PacketRadio80/T-Modem-c1224/hardware/README.md

# Hardware — T-Modem-c1224

| Path | Content | Git |
|---|---|-----|
| [`BOM.md`](BOM.md) | Planning BOM (public) | **tracked** |
| [`bom/BOM.csv`](bom/BOM.csv) | Machine-readable BOM | **tracked** |
| [`kicad/README.md`](kicad/README.md) | Pointer only | tracked stub |
| `../local/kicad/t-modem-c1224/` | Live schematic + PCB | **local only** until finished |
