PacketRadio80/T-Modem-c1224/firmware/README.md

# Firmware

Product image: **[`c1224/`](c1224/)** — one UF2 (Pico service FW).

See [`c1224/README.md`](c1224/README.md) for build, flash, pins, INI, CDC.
