PacketRadio80/T-Modem-c1224/hardware/kicad/README.md

# KiCad

Tracked project: **`hardware/kicad/t-modem-c1224/`** (fab-ready **v1.0-prototype**).

Working copies under `local/kicad/` remain gitignored for operator scratch; ship gold lives here.
