PacketRadio80/T-Modem-c1224/local/kicad/t-modem-c1224/README.md

# KiCad — T-Modem-c1224

| File | Role |
|---|---|
| `t-modem-c1224.kicad_sch` | Schematic (nets · USB VBUS isolated) |
| `t-modem-c1224.kicad_pcb` | **180×180 mm** · footprints + pads + nets · **no routed traces** |
| `t-modem-c1224.kicad_pro` | Project |

**Do not** Freeroute or hand-route until operator orders. Ratsnest only.
