PacketRadio80/T-Modem-c1224/docs/figures/c1224-board-overview.png

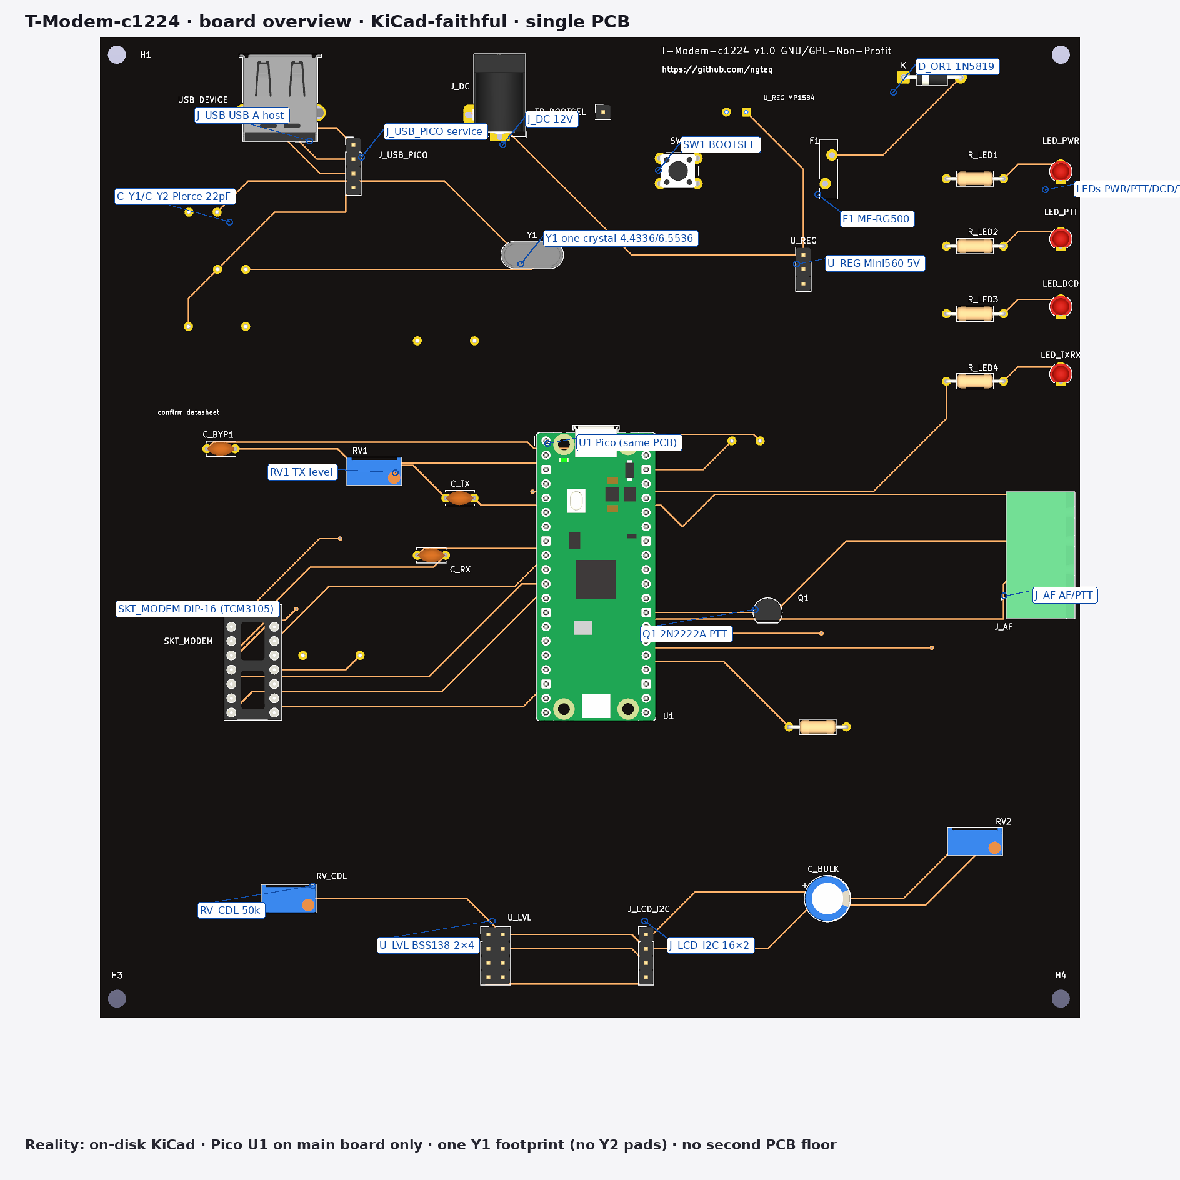
docs/figures/c1224-board-overview.png
