PacketRadio80/T-Modem-c1224/docs/figures/fig-01-pcb-standoffs.png

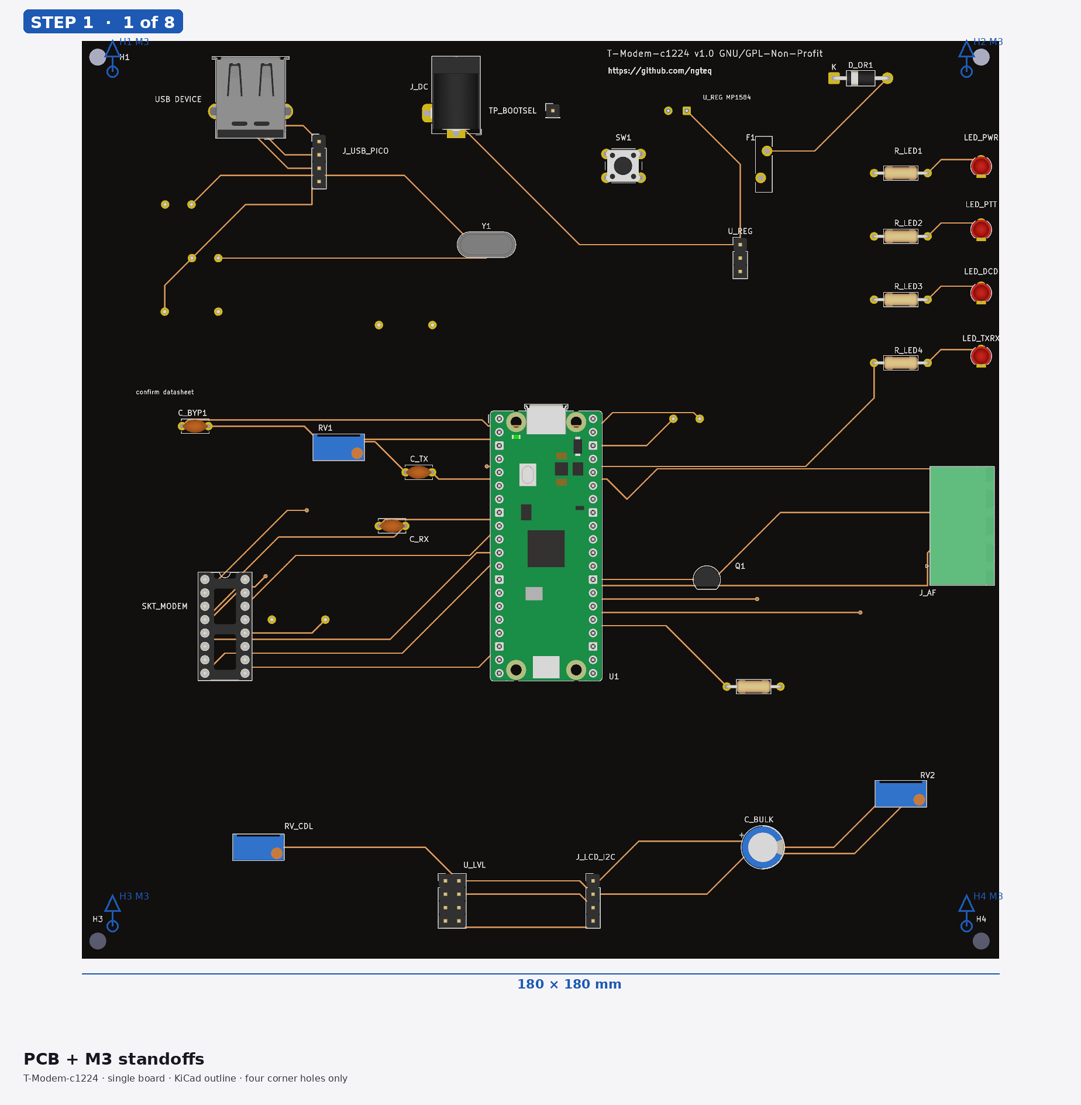
docs/figures/fig-01-pcb-standoffs.png
