PacketRadio80/T-Modem-c1224/docs/figures/fig-02-power-section.png

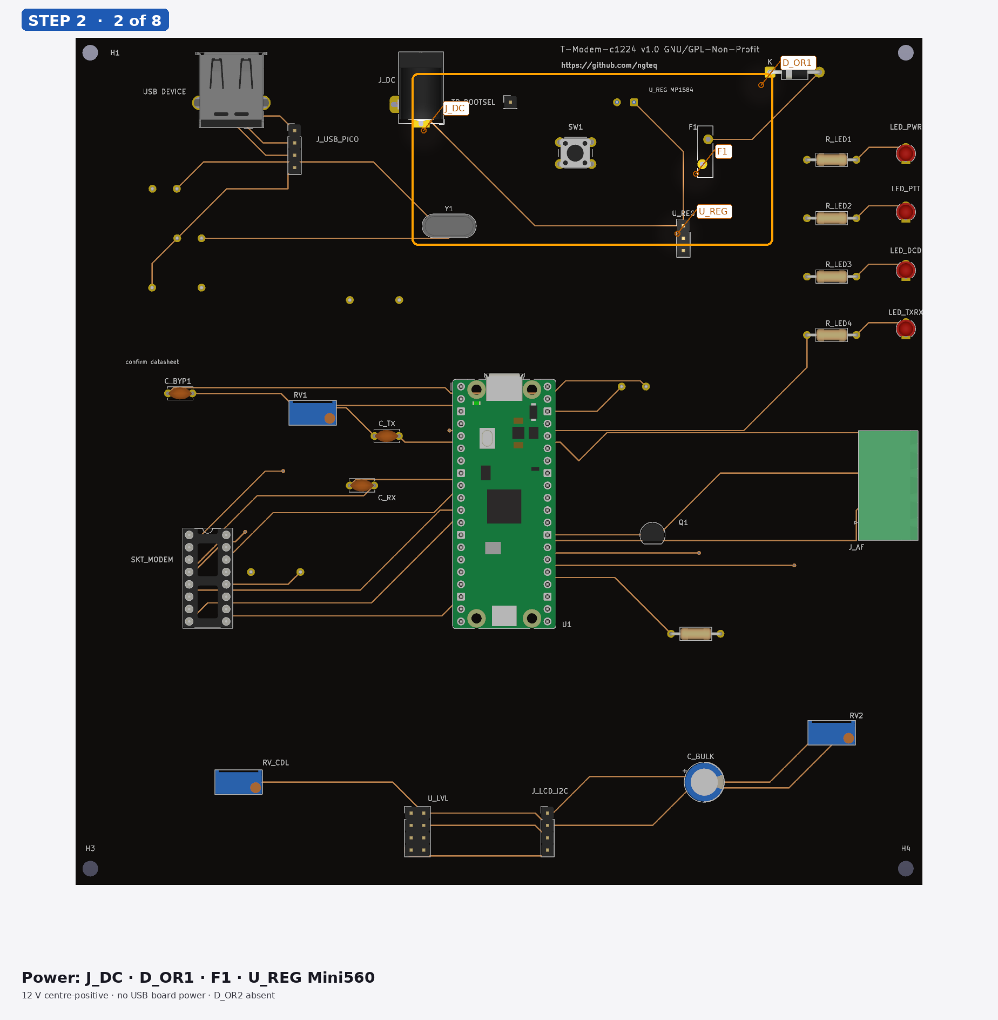
docs/figures/fig-02-power-section.png
