PacketRadio80/T-Modem-c1224/docs/figures/fig-03-modem-crystal.png

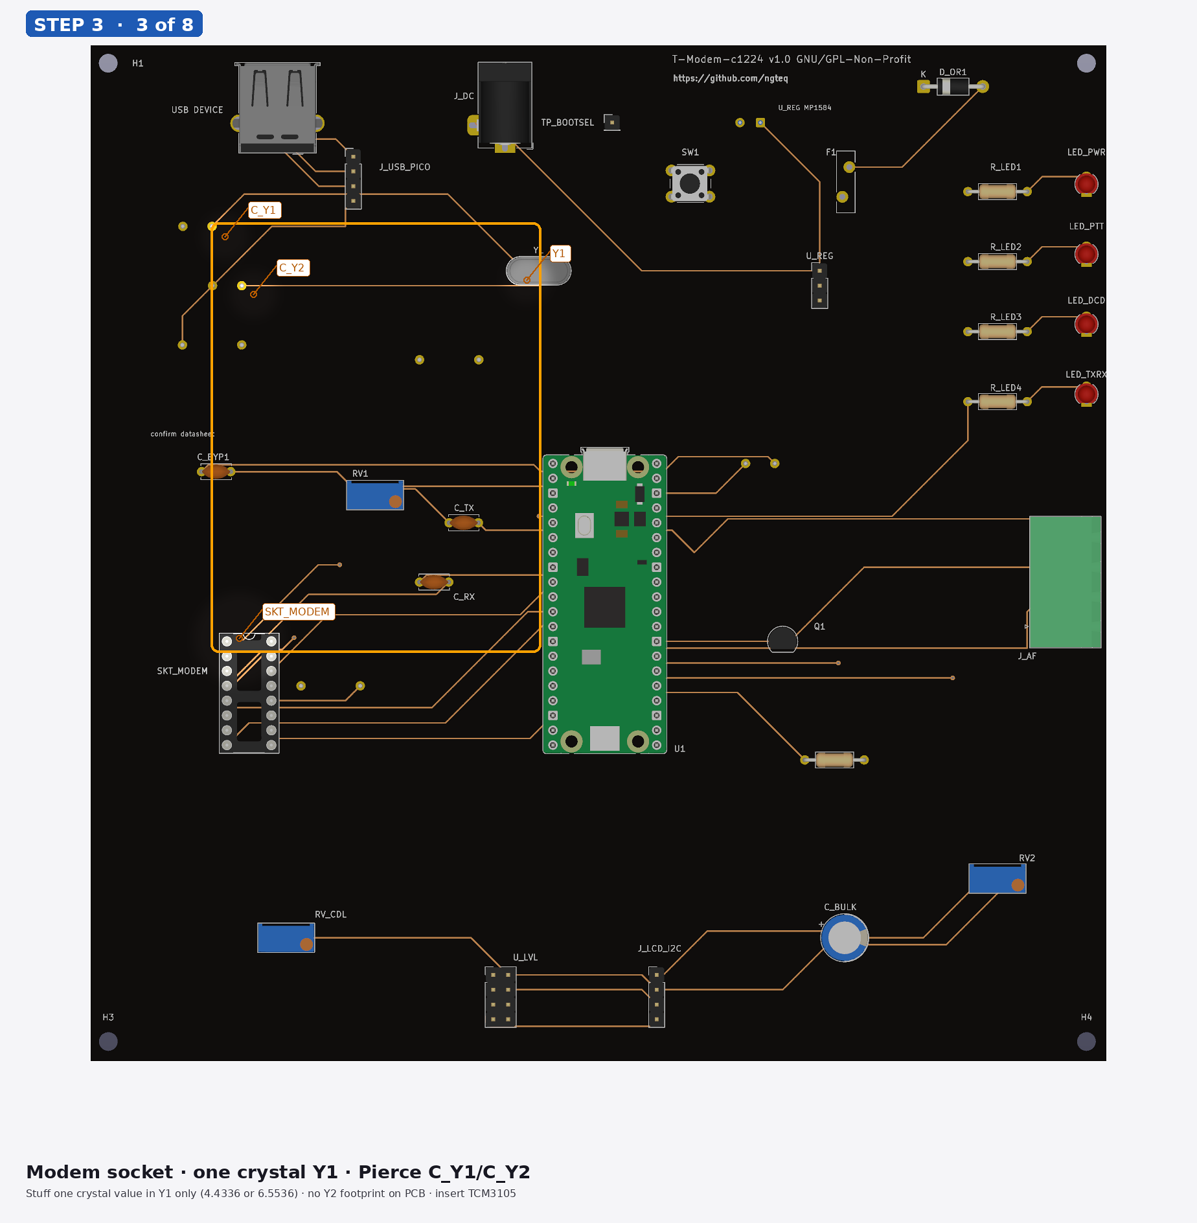
docs/figures/fig-03-modem-crystal.png
