PacketRadio80/T-Modem-c1224/docs/figures/fig-04-pico.png

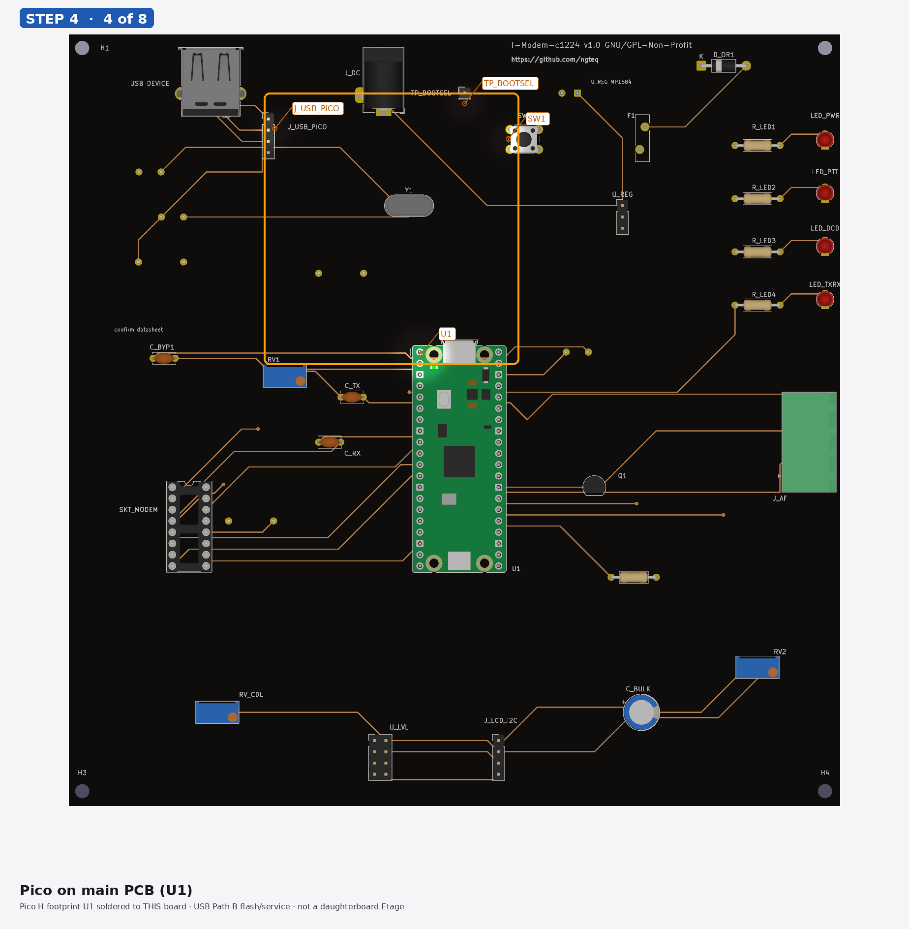
docs/figures/fig-04-pico.png
