PacketRadio80/T-Modem-c1224/docs/figures/fig-05-display.png

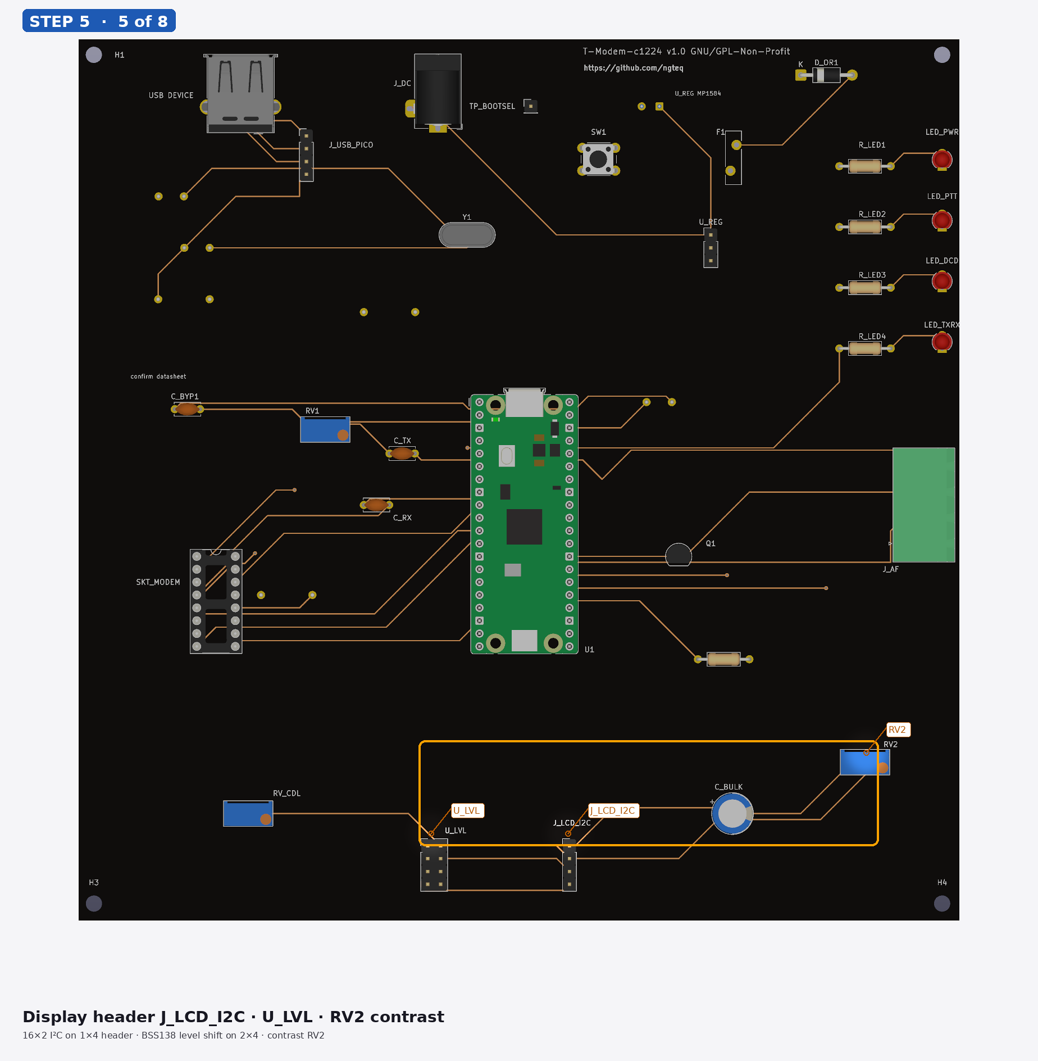
docs/figures/fig-05-display.png
