PacketRadio80/T-Modem-c1224/docs/figures/fig-06-leds.png

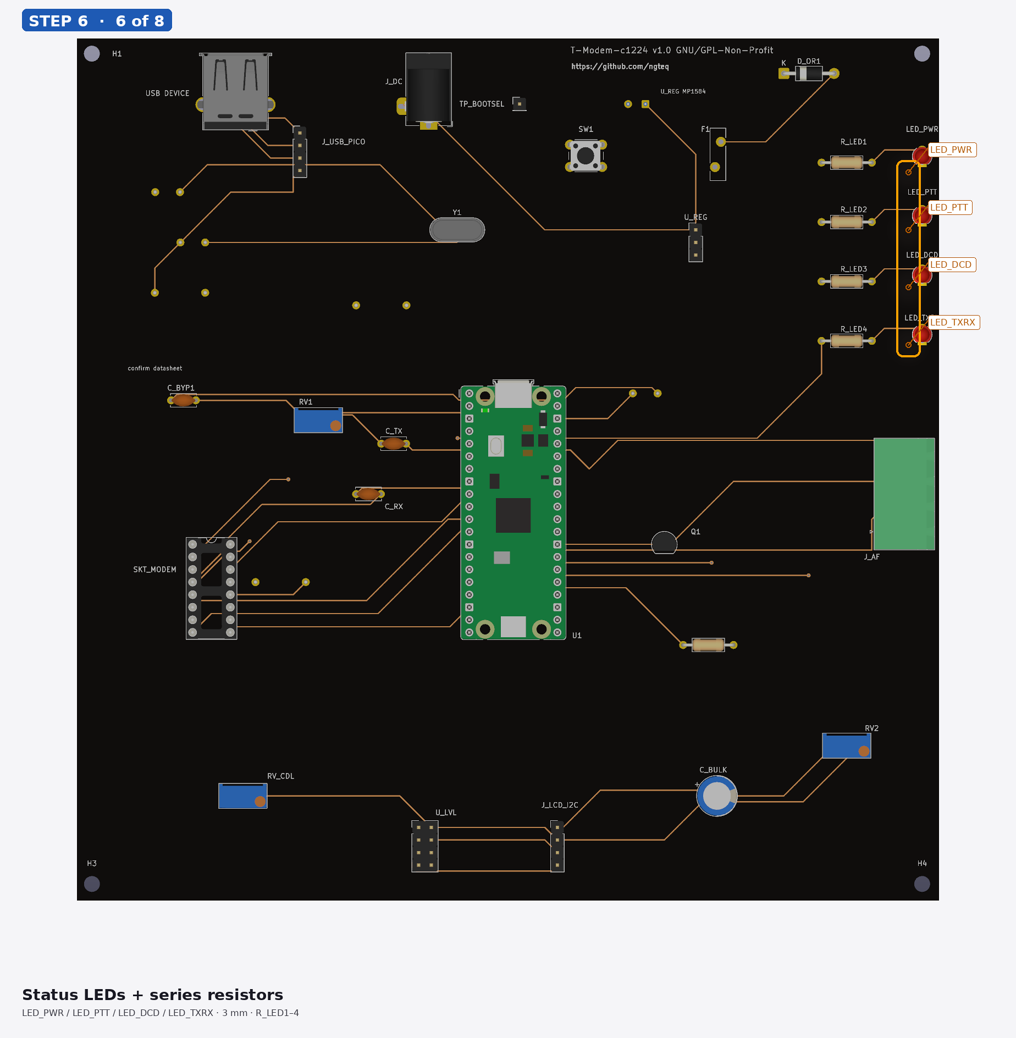
docs/figures/fig-06-leds.png
