PacketRadio80/T-Modem-c1224/docs/figures/fig-08-final-check.png

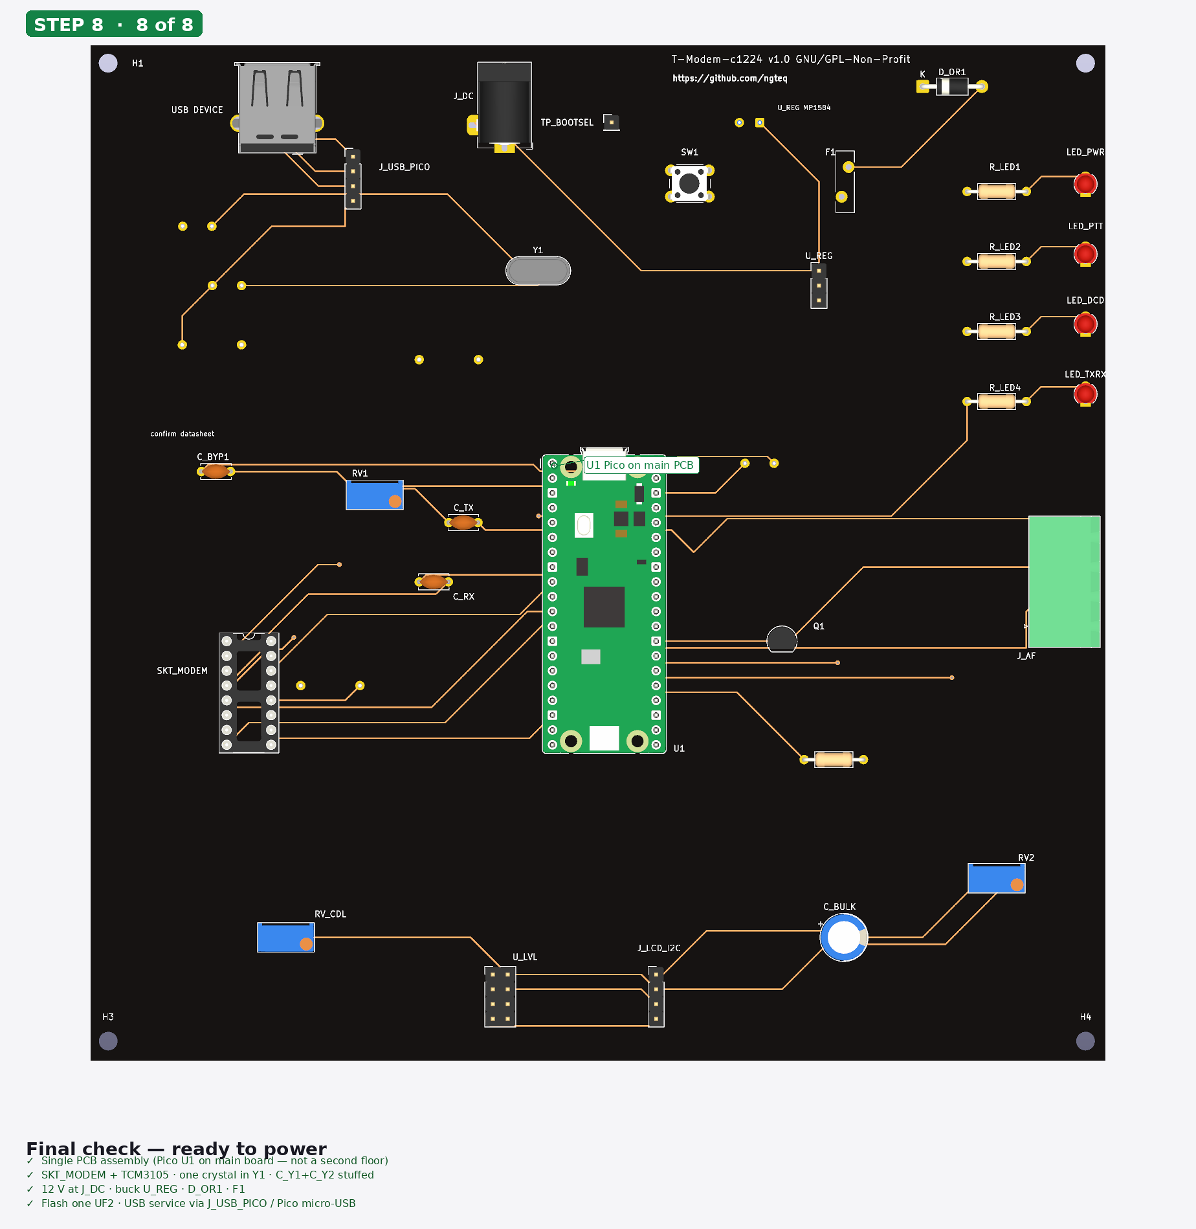
docs/figures/fig-08-final-check.png
