PacketRadio80/T-Modem-c1224/(list of files, drawings)

Other design files:
local/kicad/t-modem-c1224/t-modem-c1224.dsn
