PacketRadio80/T-Modem-c1224/hardware/kicad/t-modem-c1224/t-modem-c1224.kicad_pcb

## KiCad design hardware/kicad/t-modem-c1224/t-modem-c1224.kicad_pcb (2026-10-14)

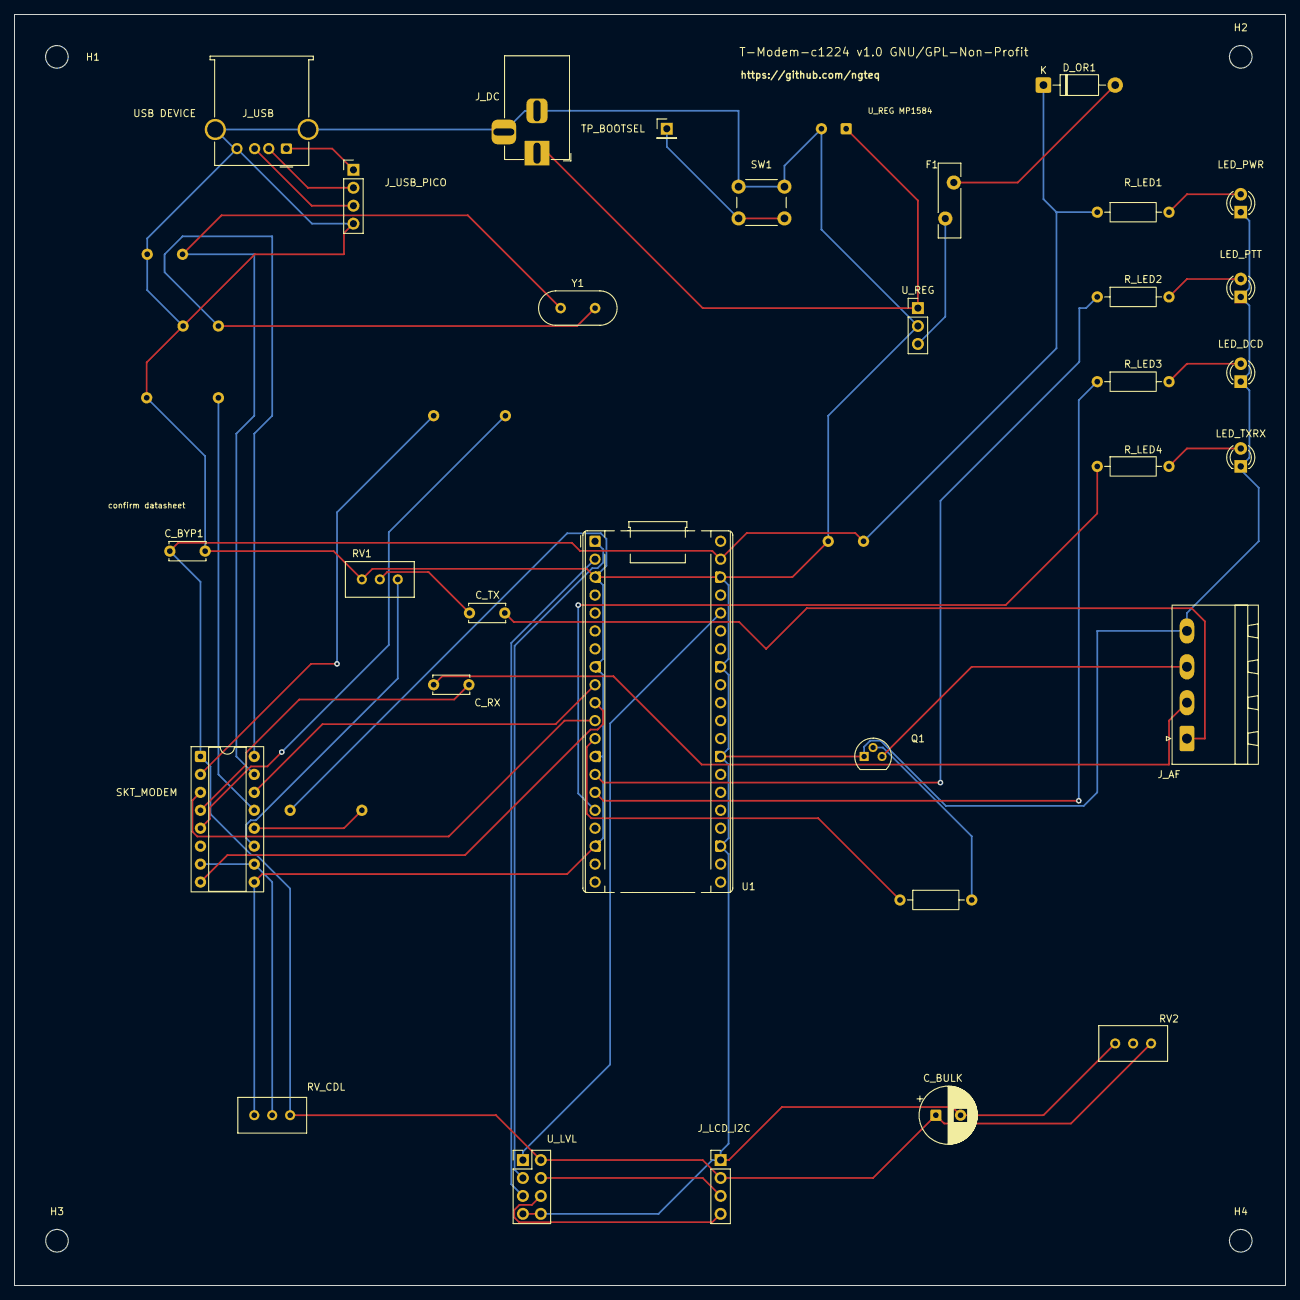
[picture p9: board t-modem-c1224.kicad_pcb from above]

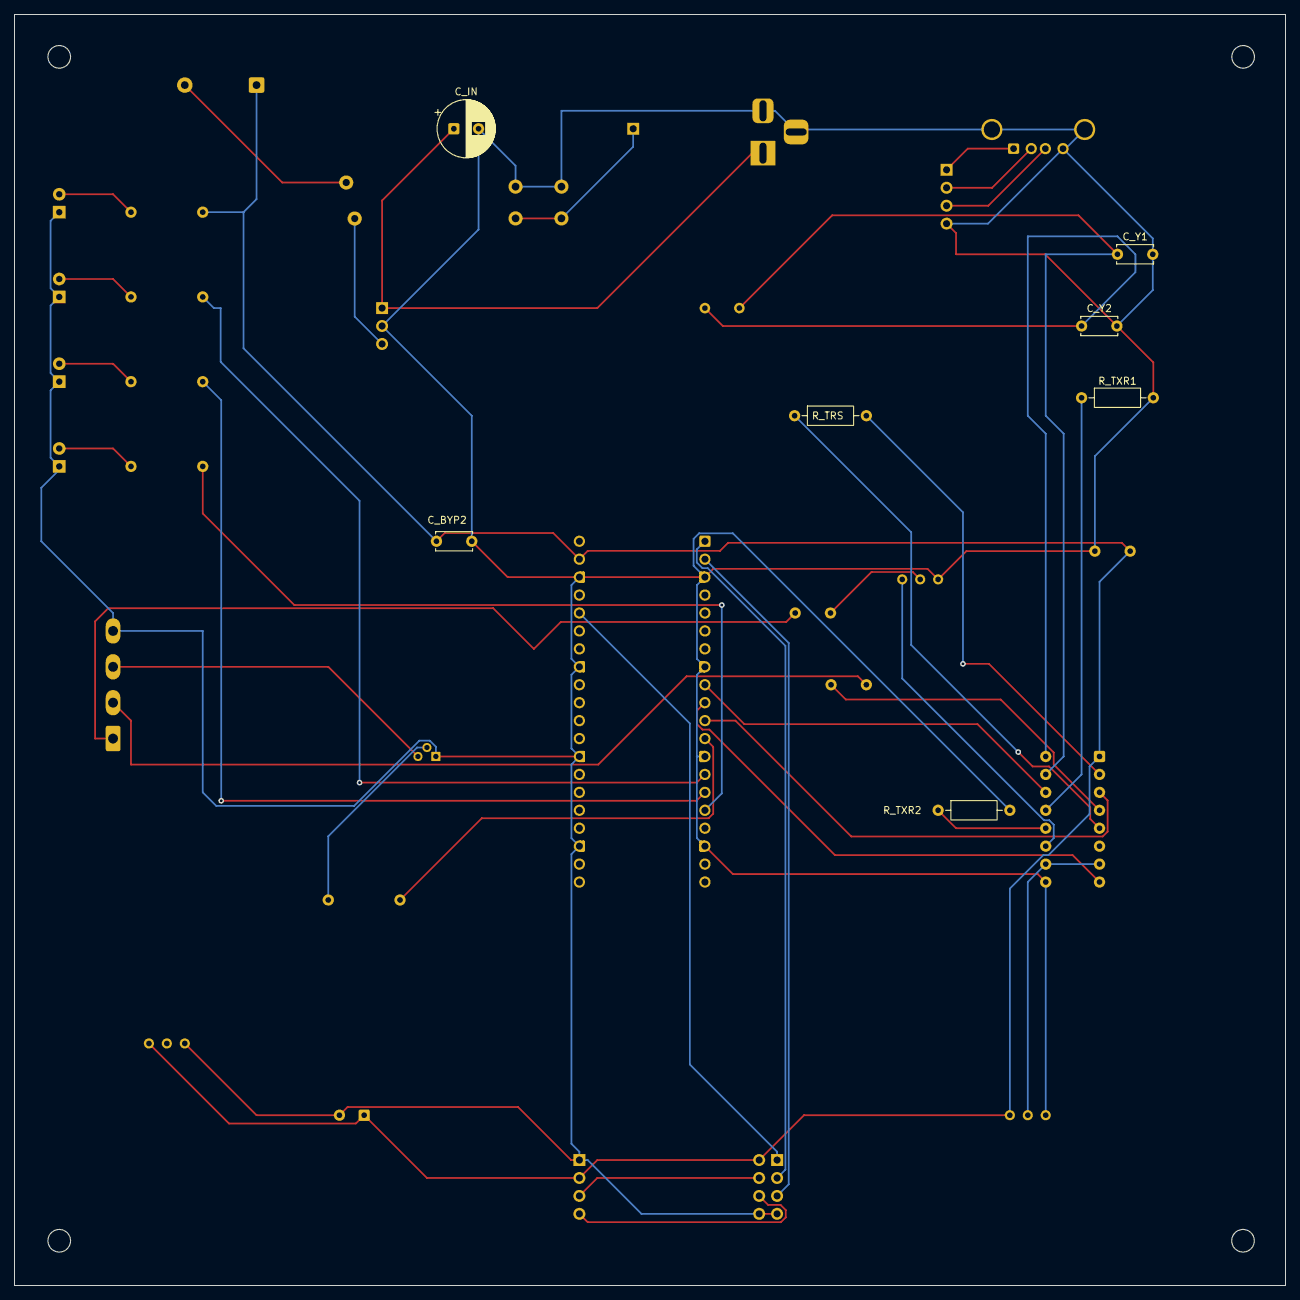
[picture p10: board t-modem-c1224.kicad_pcb from below]

Board: 2 copper layers, 180.0 x 180.0 mm, 42 parts (7 on the bottom side), 39 nets.

Parts:
C_BULK: 100uF; CP_Radial_D8.0mm_P3.50mm
C_BYP1, C_BYP2: 100nF; C_Disc_D5.0mm_W2.5mm_P5.00mm
C_IN: 100uF; CP_Radial_D8.0mm_P3.50mm
C_RX: 100nF; C_Disc_D5.0mm_W2.5mm_P5.00mm
C_TX: 100nF; C_Disc_D5.0mm_W2.5mm_P5.00mm
C_Y1, C_Y2: 22pF; C_Disc_D5.0mm_W2.5mm_P5.00mm
D_OR1: 1N5819; D_DO-41_SOD81_P10.16mm_Horizontal
F1: MF-RG500; Fuse_Bourns_MF-RG500
H1, H2, H3, H4: M3; MountingHole_3.2mm_M3
J_AF: AF; PhoenixContact_MSTBA_2,5_4-G-5,08_1x04_P5.08mm_Horizontal
J_DC: 12V CENTRE; BarrelJack_Horizontal
J_LCD_I2C: LCD I2C; PinHeader_1x04_P2.54mm_Vertical
J_USB: USB_A; USB_A_Molex_67643_Horizontal
J_USB_PICO: Pico Micro-USB cable; PinHeader_1x04_P2.54mm_Vertical
LED_DCD: DCD; LED_D3.0mm
LED_PTT: PTT; LED_D3.0mm
LED_PWR: PWR; LED_D3.0mm
LED_TXRX: TXRX; LED_D3.0mm
Q1: 2N2222A; TO-92
RV1: 10k TX; Potentiometer_Bourns_3296W_Vertical
RV2: 10k contrast; Potentiometer_Bourns_3296W_Vertical
RV_CDL: 50k CDL; Potentiometer_Bourns_3296W_Vertical
R_LED1, R_LED2, R_LED3, R_LED4: 1k; R_Axial_DIN0207_L6.3mm_D2.5mm_P10.16mm_Horizontal
R_PTT: 4.7k; R_Axial_DIN0207_L6.3mm_D2.5mm_P10.16mm_Horizontal
R_TRS: 0R; R_Axial_DIN0207_L6.3mm_D2.5mm_P10.16mm_Horizontal
R_TXR1, R_TXR2: 0R; R_Axial_DIN0207_L6.3mm_D2.5mm_P10.16mm_Horizontal
SKT_MODEM: U_MODEM TCM3105; DIP-16_W7.62mm_Socket
SW1: BOOTSEL; SW_PUSH_6mm
TP_BOOTSEL: Pico BOOTSEL; PinHeader_1x01_P2.54mm_Vertical
U1: RPi-Pico; RaspberryPi_Pico_Common_THT
U_LVL: BSS138; PinHeader_2x04_P2.54mm_Vertical
U_REG: Mini560-5V; PinHeader_1x03_P2.54mm_Vertical
Y1: 4.4336/6.5536Mhz; Crystal_HC49-U_Vertical

Connections:
3V3: U1.36, U_LVL.1
+5V: D_OR1.2, F1.2
+5V_OR: C_BULK.1, C_BYP1.1, C_BYP2.1, D_OR1.1, J_LCD_I2C.2, RV2.1, RV_CDL.1, R_LED1.1, SKT_MODEM.1, U1.39, U_LVL.2
+5V_REG: F1.1, U_REG.3
AF_RX: C_RX.1, J_AF.2
AF_TX: C_TX.2, J_AF.1
BOOTSEL: SW1.2, TP_BOOTSEL.1
CDL: RV_CDL.2, SKT_MODEM.7, SKT_MODEM.10
GND: C_BULK.2, C_BYP1.2, C_BYP2.2, C_IN.2, C_Y1.2, C_Y2.2, J_AF.4, J_DC.2, J_DC.3, J_LCD_I2C.1, J_USB.4, J_USB.SH, J_USB_PICO.4, LED_DCD.1, LED_PTT.1, LED_PWR.1, LED_TXRX.1, Q1.1, RV1.3, RV2.3, RV_CDL.3, R_TXR1.2, R_TXR2.2, SKT_MODEM.9, SW1.1, U1.3, U1.8, U1.13, U1.18, U1.23, U1.28, U1.33, U1.38, U_LVL.7, U_LVL.8, U_REG.2
I2C_SCL_3V3: U1.2, U_LVL.5
I2C_SCL_5V: J_LCD_I2C.4, U_LVL.6
I2C_SDA_3V3: U1.1, U_LVL.3
I2C_SDA_5V: J_LCD_I2C.3, U_LVL.4
LED_DCD_A: LED_DCD.2, R_LED3.2
LED_DCD_N: R_LED3.1, U1.15
LED_PTT_A: LED_PTT.2, R_LED2.2
LED_PTT_N: R_LED2.1, U1.14
LED_PWR_A: LED_PWR.2, R_LED1.2
LED_TXRX_A: LED_TXRX.2, R_LED4.2
LED_TXRX_N: R_LED4.1, U1.16
MODEM_CDT: SKT_MODEM.3, U1.11
MODEM_CLK: R_TRS.2, SKT_MODEM.2
MODEM_RXD: SKT_MODEM.8, U1.10
MODEM_TXD: SKT_MODEM.14, U1.9
OSC1: C_Y1.1, SKT_MODEM.15, Y1.1
OSC2: C_Y2.1, SKT_MODEM.16, Y1.2
PTT_B: Q1.2, R_PTT.2
PTT_DRV: R_PTT.1, U1.12
PTT_OC: J_AF.3, Q1.3
RXA: C_RX.2, SKT_MODEM.4
TRS_N: R_TRS.1, SKT_MODEM.5
TXA: RV1.1, SKT_MODEM.11
TXR1_N: R_TXR1.1, SKT_MODEM.13
TXR2_N: R_TXR2.1, SKT_MODEM.12
TX_LVL: C_TX.1, RV1.2
USB_DM: J_USB.2, J_USB_PICO.2
USB_DP: J_USB.3, J_USB_PICO.3
USB_VBUS_NC: J_USB.1, J_USB_PICO.1
VIN_12: C_IN.1, J_DC.1, U_REG.1
