PacketRadio80/T-Modem-c1224/(commit log)

2026-10-14 Initial release: T-Modem-c1224 v1.0-prototype
    USB KISS half-TNC for Raspberry Pi Pico with TCM3105 chip PHY.
    Includes pre-built firmware for 1200 and 2400 baud.
    Features:
    - HDLC + bitbang AFSK to TCM3105 modem chip
    - KISS (0xC0) + ASCII service protocol over USB CDC
    - PTT control, signal/carrier sense, I2C display
    - Watchdog protection, I2C timeout recovery
    - Crystal-selected baud rate (Y1=1200, Y2=2400)
    All automated software tests passed. Field testing pending.
    License: GPLv3 — Non-profit
    [BOM.csv, t-modem-c1224.dsn, t-modem-c1224.kicad_pcb, t-modem-c1224.kicad_sch]
2026-10-15 Fix KISS decoding and match carrier detect to the modem chip
    KISS DATA frames were silently dropped: FEND closed the frame instead
    of opening it, so host software could never key the transmitter. FEND
    now opens a frame and the next FEND closes it.
    The modem chip's carrier detect is active high; the config default was
    active low, which made the carrier gate look permanently closed. The
    default now matches the hardware. STATUS also reports the PTT driver
    pin (gp9). BOOTSEL/DFU, REBOOT and the 1200bps DTR-loss touch allow
    unattended reflashing, with the watchdog disabled before entering the
    bootrom.
    💘 Generated with Crush
    Assisted-by: Crush:mimo-v2.6-pro
    [config.c, kiss.c]
2026-10-15 Add complete build and operation documentation
    New docs/dok walks anyone through what the board is and how to reach
    on-air packet: parts, stuffing and crystal choice, firmware build
    matching the crystal, flashing (including unattended CLI reflashing),
    commissioning, KISS and CLI operation with the FCS contract for host
    authors, configuration, host software and troubleshooting. The
    existing guides only gain links and the new BOOTSEL/REBOOT commands.
    The example INI now matches the active-high carrier-detect default.
    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
2026-10-16 Harden TX path and bring KISS params to the s1224 contract
    The bit-bang TX loop now feeds the watchdog every 256 bits and the
    TXDELAY/TXTAIL waits are sliced, so long frames and configurable
    timing can no longer trip the 8s watchdog mid-transmission. At low
    crystal rates a maximum frame alone exceeds that window.
    TX timing follows the half-TNC contract: TXDELAY and TXTAIL are
    honored via the new tx_delay_ms/txtail_ms INI keys (defaults 500/100,
    previously hardcoded 40/20), and SLOTTIME/PERSIST/FULLDUP are rejected
    with a notice instead of being silently swallowed. A decoder buffer
    overflow resets the escape state so a truncated frame cannot corrupt
    the next one. STATUS reports the active TX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
    [afsk_bitbang.c, config.c, kiss.c]
2026-10-17 Release v1.0 firmware: Pro-Banner, wedge fix, tone test
    Bump to 1.0 with the Pro-Banner. Fix the KISS wedge that left the CLI
    unresponsive after a stray frame (idle-timeout parser reset). Add a
    continuous AFSK tone test (TONE HIGH/LOW/OFF) for bench TX alignment.
    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
    [afsk_bitbang.c, banner.c]
2026-10-17 Document TX AF buffer retrofit (Lösung 1)
    The PCB omits a TX AF output buffer, so RV1 overloads the TCM3105 TXA
    (needs >=50 kOhm, has 10 kOhm) and TX audio stays weak regardless of
    the RV1 setting. Add a unity-gain op-amp buffer to retrofit and note
    the missing component in the README.
    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
    [BOM.csv]
