PacketRadio80/T-Modem-c1224/(notices)

Notices in the files:
local/kicad/t-modem-c1224/t-modem-c1224.kicad_sch:
ngteq GPLv3 AS-IS standard reference
local/kicad/t-modem-c1224/t-modem-c1224.kicad_pcb:
T-Modem-c1224 v1.0 GNU/GPL-Non-Profit
